mrstefangrimm/fruit-crate/README.md

# fruit crate

For more info, please have a look at the instructable:

 - [English description](https://www.instructables.com/Replica-of-a-Vintage-Fruit-Crate/)
 - [Deutsche Beschreibung]( https://www.instructables.com/Nachbildung-Einer-Obstkiste-Im-Vintage-Stil/)
