mrstefangrimm/fruit-crate/SketchUp/Back.jpg

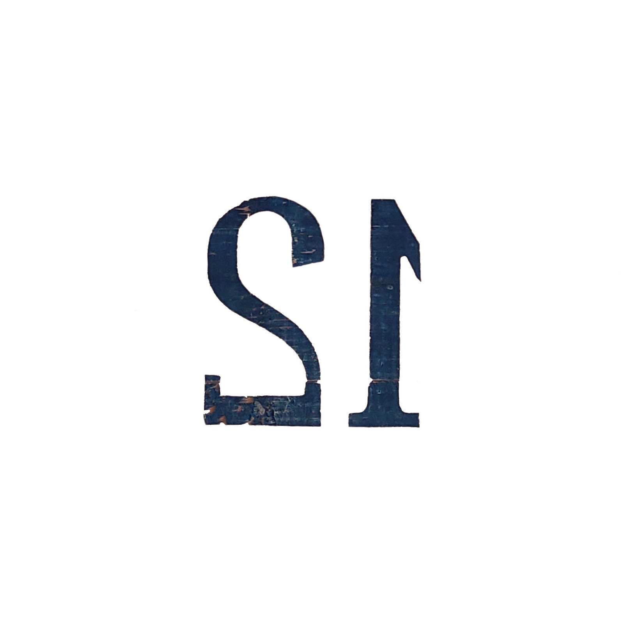
SketchUp/Back.jpg
