mrstefangrimm/fruit-crate/SketchUp/Back.png

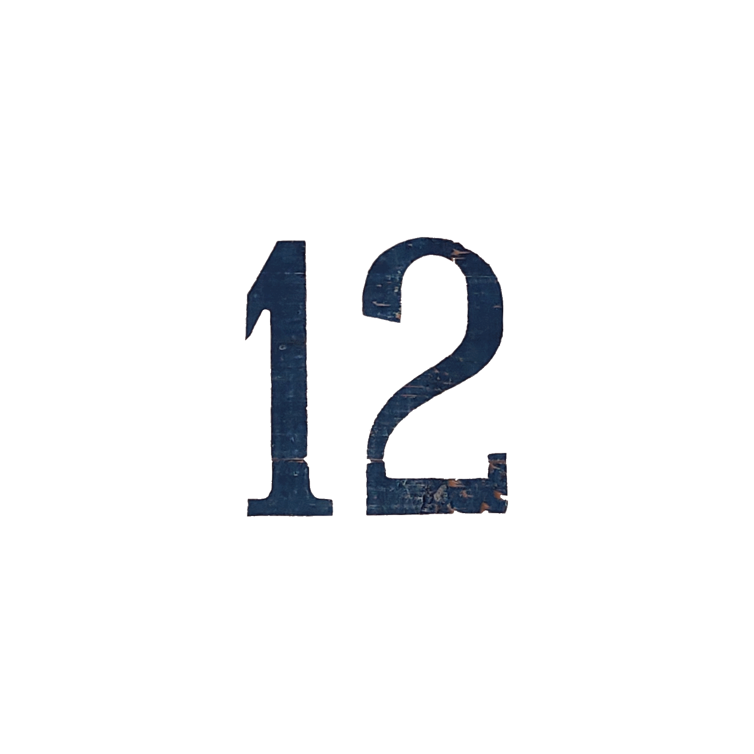
SketchUp/Back.png
