mrstefangrimm/fruit-crate/SketchUp/Front.png

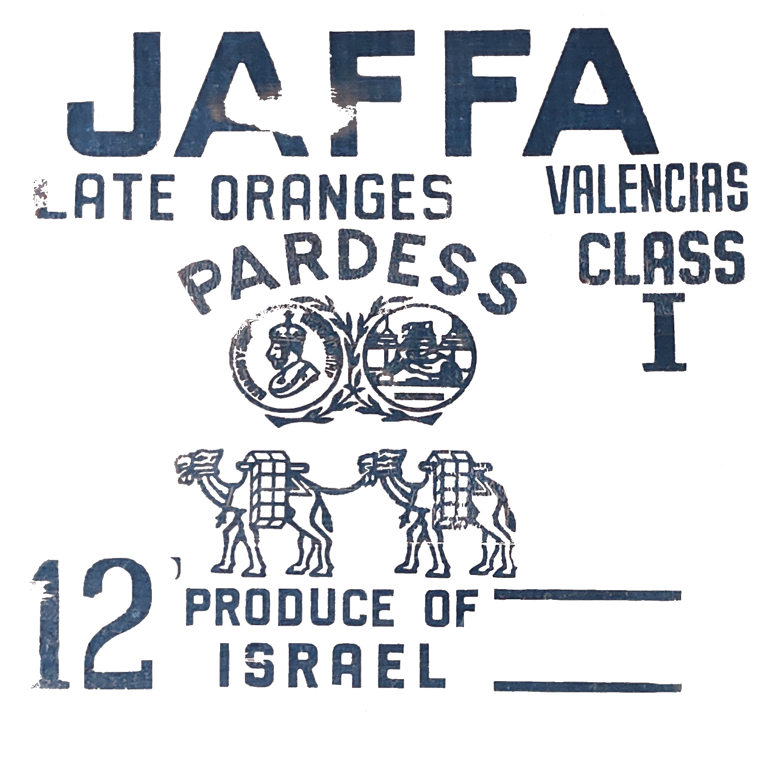
SketchUp/Front.png
