mrstefangrimm/fruit-crate/(list of files, cad)

Other CAD files:
SketchUp/Timber1.skp
SketchUp/Timber2.skp
SketchUp/Timber3.skp
SketchUp/model.skp
