mrstefangrimm/fruit-crate/Instructable/instructions-DE.md

# Nachbildung einer Obstkiste im Vintage-Stil

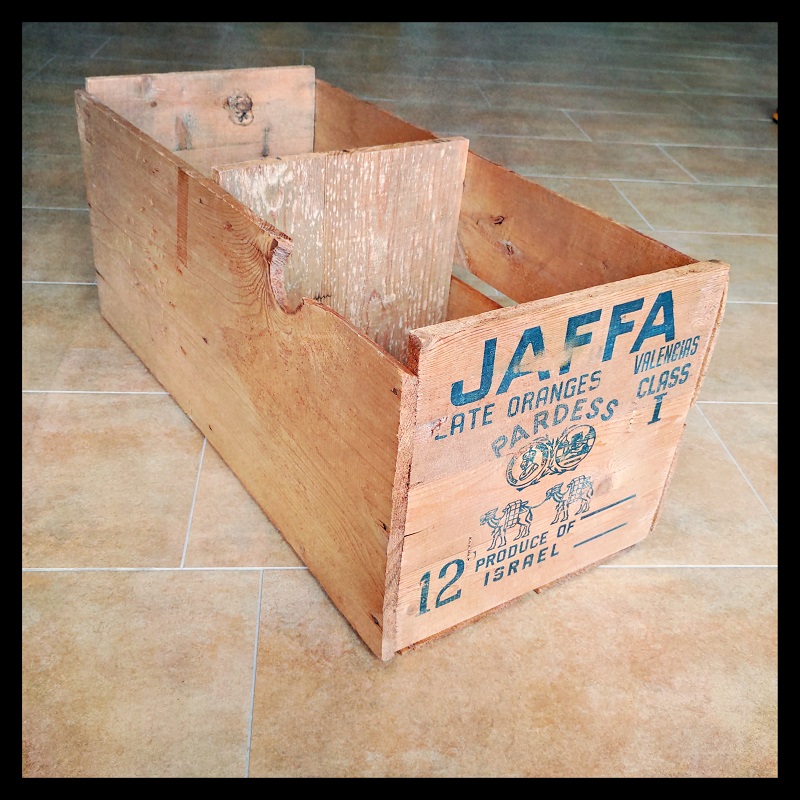
[picture p4: Instructable/OrgCrate.jpg]
Original crate


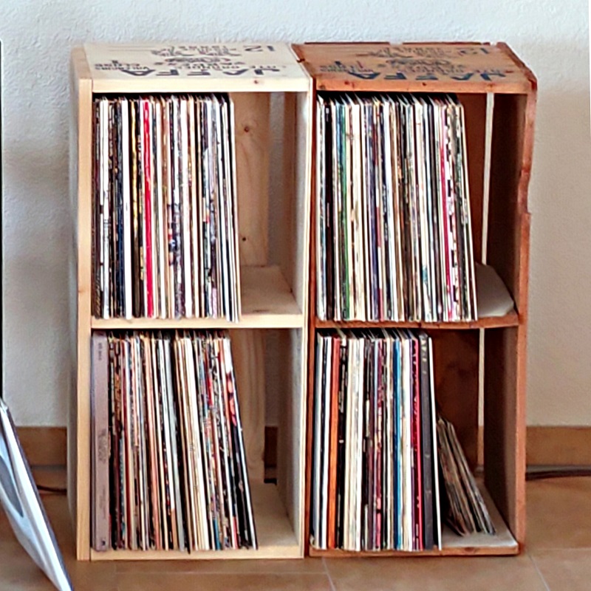
[picture p5: Instructable/Result2.jpg]
Result


Vor einigen Jahren habe ich diese alte Holzkiste in einem Dachstock entdeckt, voll von Staub und Spinnennetzen. Mal gereinigt stellte sich heraus, dass sie sich hervorragen als Schallplattenregal eignet.

Ich habe eine Weile auf dem Internet gesucht und konnte keine weitere solche Kiste auftreiben, also habe ich mir kurzerhand selbst eine gebaut. Diese Kisten sind so genial einfach gebaut, dass es einfach Spass macht, selbst eine zu zimmern.

Das Holz könnt ihr im Baumarkt zuschneiden lassen. Dort gibt es auch den Foto Transfer Gel und Klarlack zu kaufen; falls ihr am Schluss das Holz lackieren wollt. Bevor ihr euch auf den Weg zum Baumarkt macht, klärt bitte ab, ob der Foto Transfer Gel vorrätig ist.

Die Kosten waren ca. 40 EUR, wobei der Holzzuschnitt die Hauptkosten verursachte.

**Supplies**

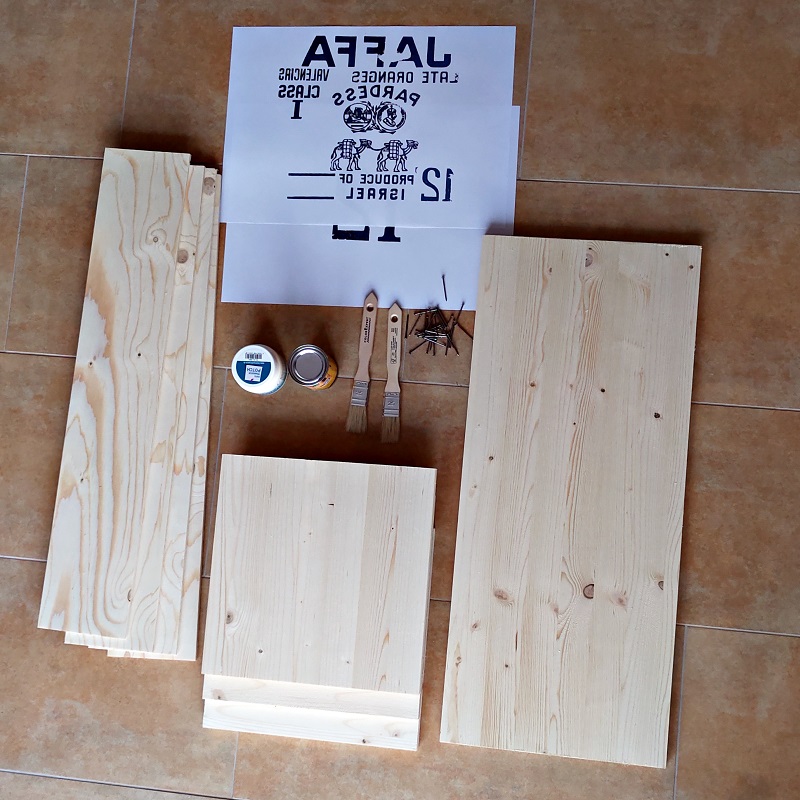
[picture p6: Instructable/Parts.jpg]
Parts


2 Laserdruck, max. 30x30 cm

1 Foto Transfer Gel, min. 50 ml

1 Klarlack für Holz, min 50 ml

1 Massivholz Fichte 700x300x12 mm

3 Massivholz Fichte 300x300x15 mm

4  Sperrholz Fichte 700x130x6.5 mm

33 Nagel 1.8x35 mm

## 1 Foto Transfer

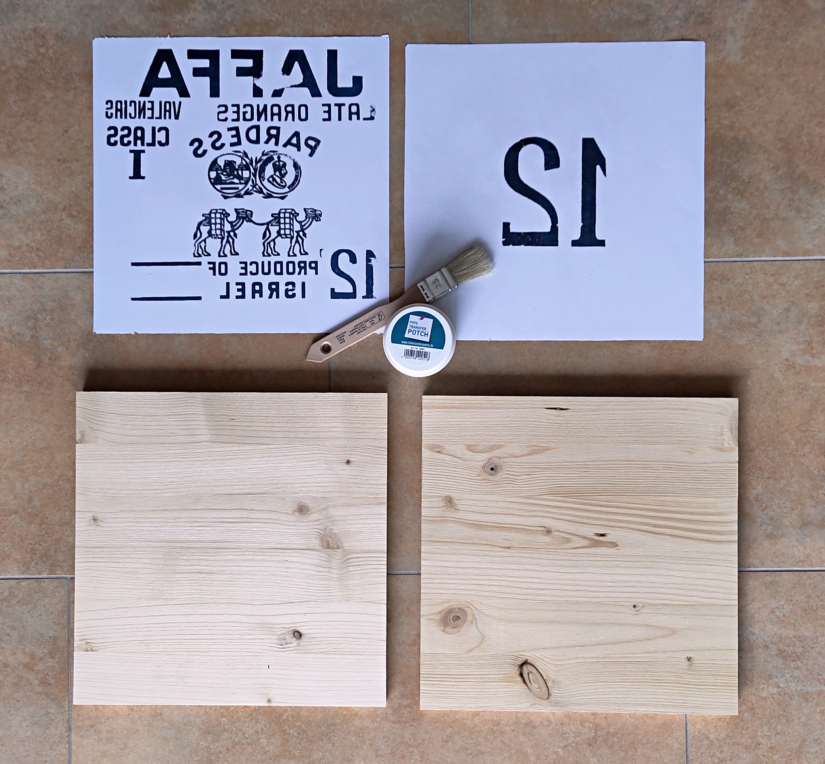
[picture p7: Instructable/PhotoTransfer1.jpg]
Foto Transfer


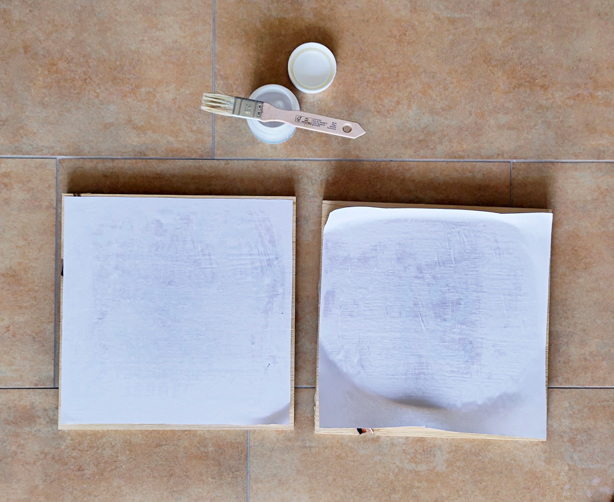
[picture p8: Instructable/PhotoTransfer2.jpg]
Foto Transfer


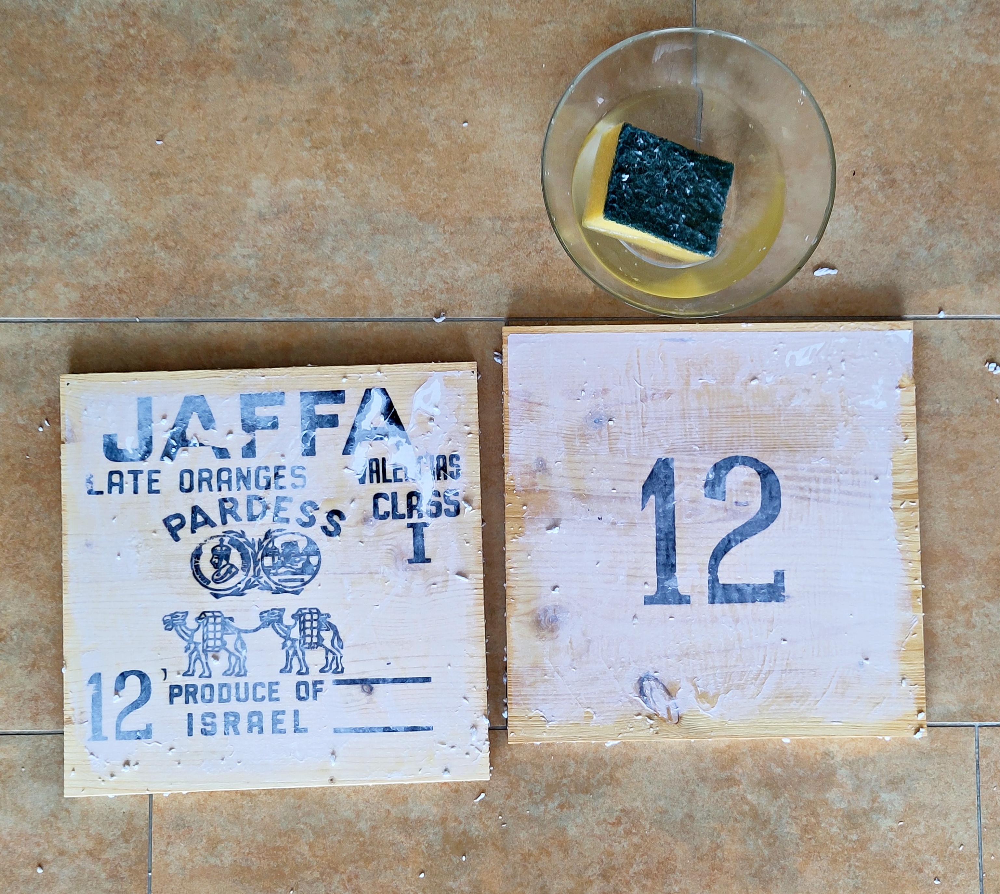
[picture p9: Instructable/PhotoTransfer3.jpg]
Foto Transfer


Das Holz und der Laserdruck sind mit dem Foto Transfer Medium satt einzustreichen. Dann legt ihr das Papier auf das Holz und drückt vorsichtig alle Luftbläschen raus.

Wartet dann 24 Stunden.

Mit einem feuchten Schwamm könnt ihr dann das Papier abrubbeln. Die Farbe ist in der Schicht des getrockneten Gels und wird dabei nicht abgewaschen.

Ich habe das zum ersten Mal gemacht und würde das nächste Mal die Drucke nicht ausschneiden wie es den Fotos zu sehen ist. Ich würde die gesamte Holzplatte mit dem Gel bestreichen und mit dem Ausdruck bedecken, so dass es eine gleichmässige Gelschicht über die ganz Platte gibt.

## Zimmern - Massive Wand

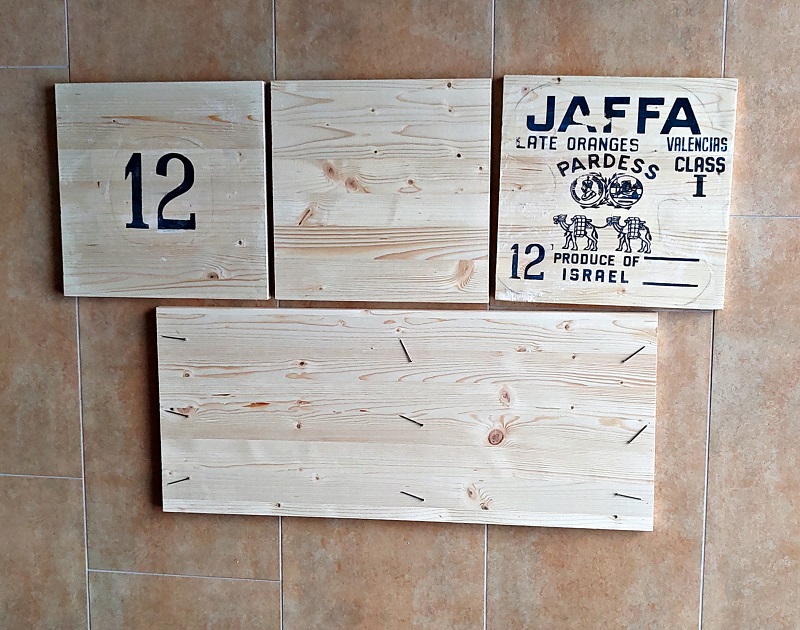
[picture p10: Instructable/TimberParts1.jpg]


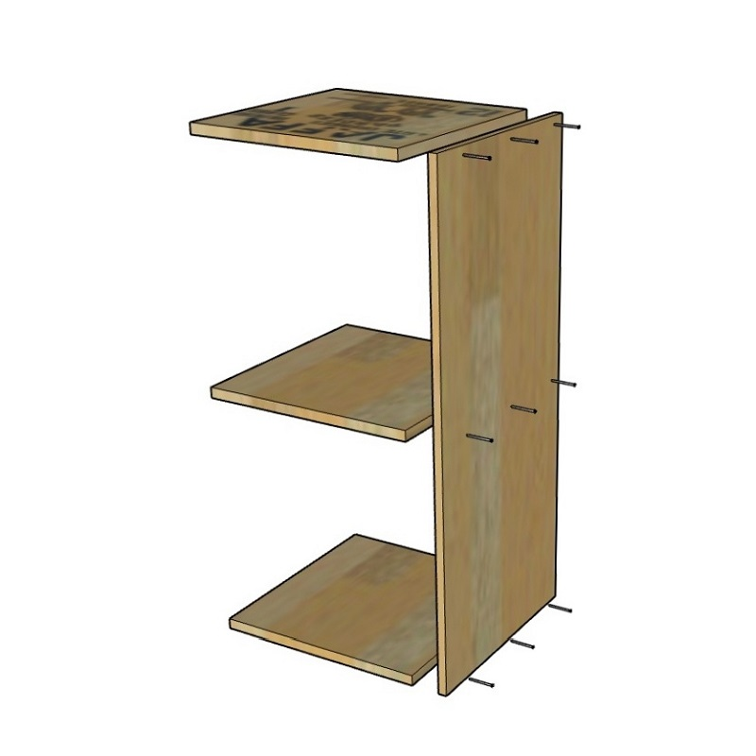
[picture p11: Instructable/Timber1.jpg]


Die Vorder- und Rückwand und die Mittelwand werden mit jeweils 3 Nägeln befestigt. Die Nägel werden im Abstand von 40 mm zur Seitenkante und 7.5 mm zur Ober- und Unterkante eingeschlagen.

## Zimmern - Gegenüberliegende Wand

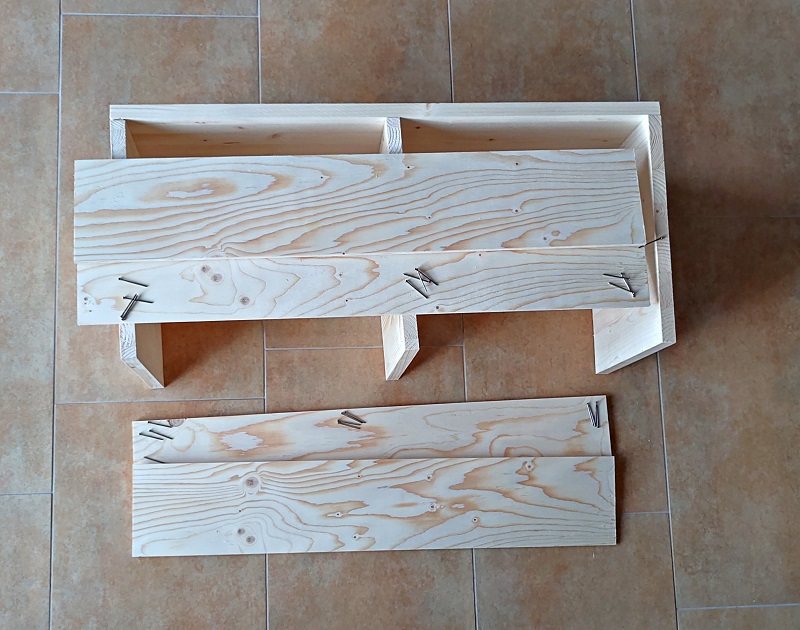
[picture p12: Instructable/TimberParts2.jpg]


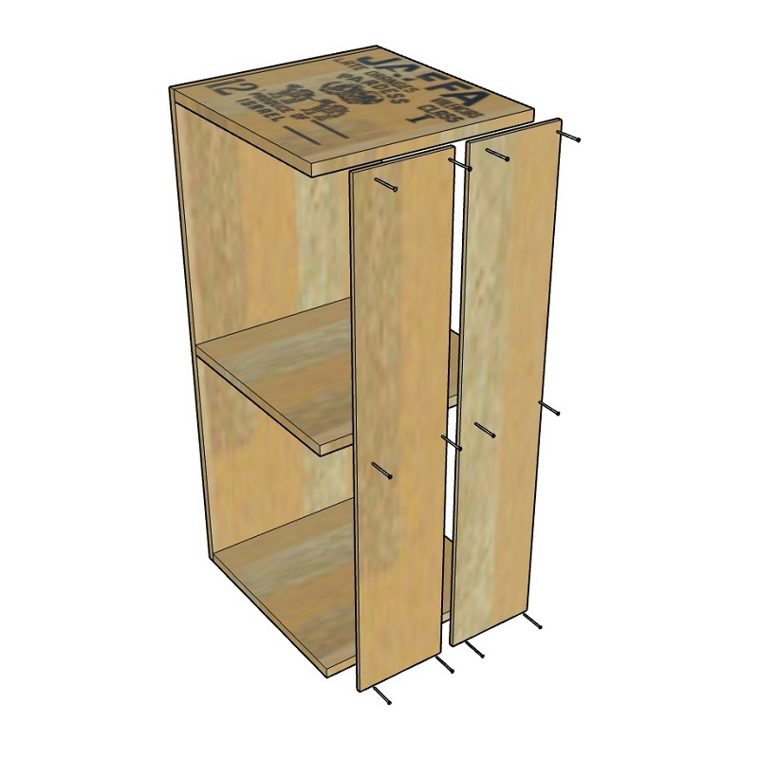
[picture p13: Instructable/Timber2.jpg]


Auf der Seite gegenüber der Massivholzwand wird das vordere Sperrholzbrett bündig zur vorderen Kante befestigt. Das hintere Sperrholzbrett wird mit 20 mm Abstand zur hinteren Kante befestigt.

Die Nägel werden im Abstand von 15 mm zur Seitenkante und 7.5 mm zur Ober- und Unterkante eingeschlagen.

## Zimmern - Rückwand

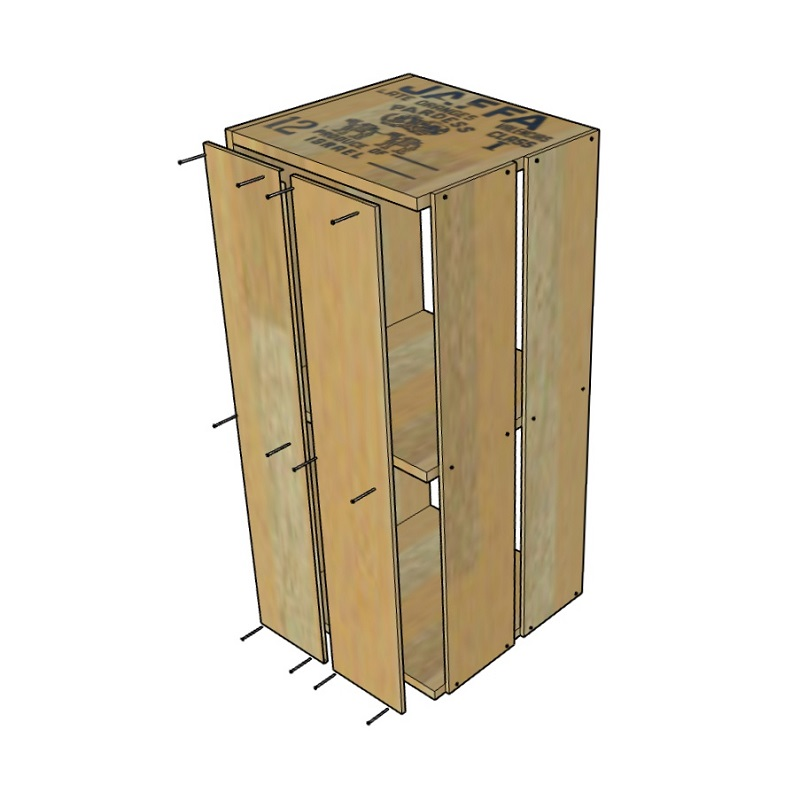
[picture p14: Instructable/Timber3.jpg]


Auf der Seite welche die Rückwand des Regals bildet wird das vordere Sperrholzbrett mit 14 mm Abstand zur Kante befestigt. Den Spalt zwischen der Massivholzwand und dem hinteren Sperrholzbrett wird 8 mm offen gelassen.

Die Nägel werden im Abstand von 15 mm zur Seitenkante und 7.5 mm zur Ober- und Unterkante eingeschlagen.

## Fertigstellen

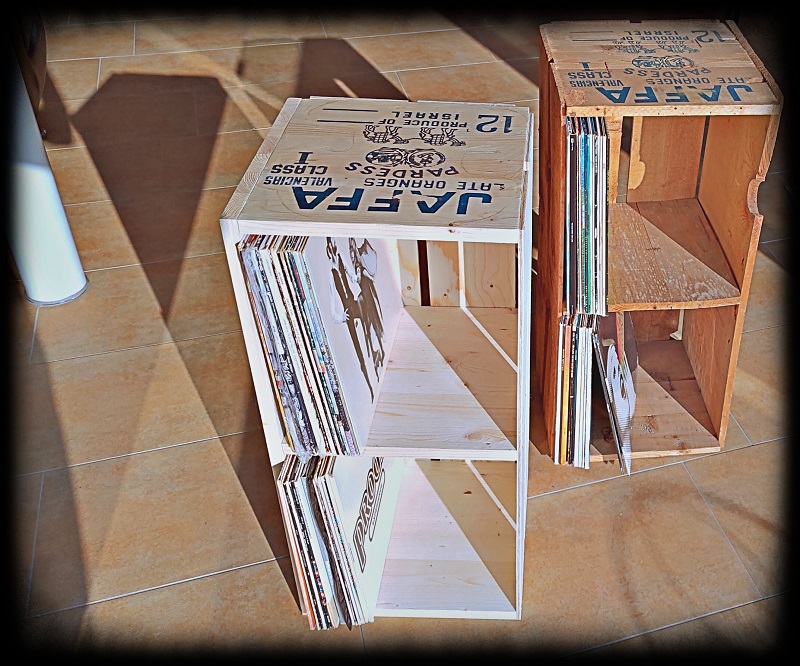
[picture p15: Instructable/Result1.jpg]


Zu Schutz könnt ihr das Holz mit dem Klarlack einstreichen. Ich habe nur die bedruckten Seiten mit dem Lack geschützt.

Das ist die Nachbildung einer Obstkiste im Vintage-Stil.
