mrstefangrimm/fruit-crate/Instructable/Front.jpg

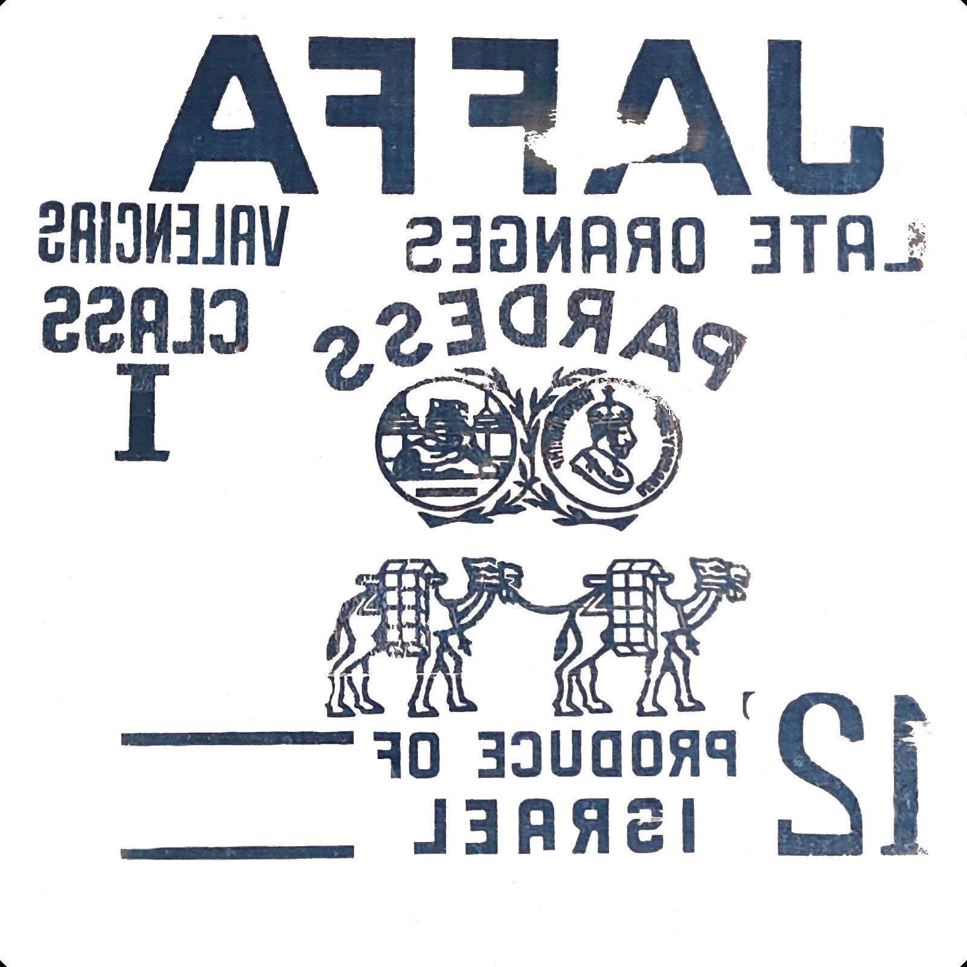
Instructable/Front.jpg
